UofC-GNCTR-2024/Claw-Machine-Mechanicals/pcb_enclosure/grommet - main (12mm).stl

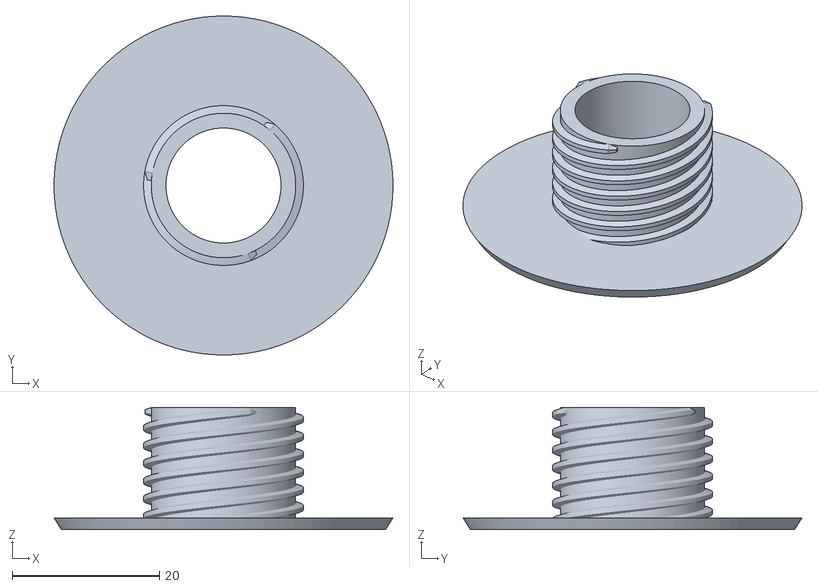
[picture p1: CAD file, 2023-12-17]
pcb_enclosure/grommet - main (12mm).stl
46.0 x 46.0 x 16.6
