UofC-GNCTR-2024/Claw-Machine-Mechanicals/pcb_enclosure/grommet - main (20mm).stl

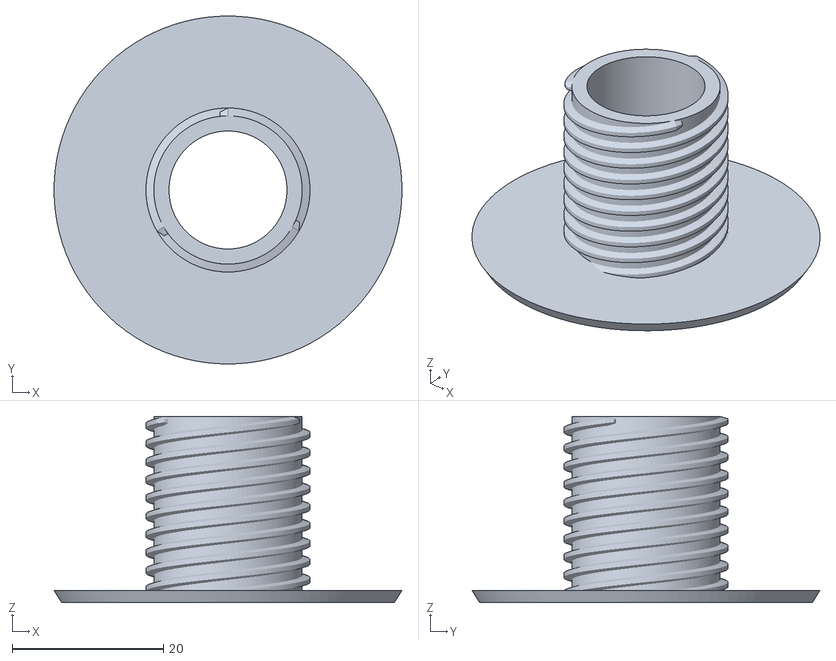
[picture p2: CAD file, 2023-12-17]
pcb_enclosure/grommet - main (20mm).stl
46.0 x 46.0 x 24.6
