UofC-GNCTR-2024/Claw-Machine-Mechanicals/axis_parts/sliders/y_axis_sled - bottom.stl

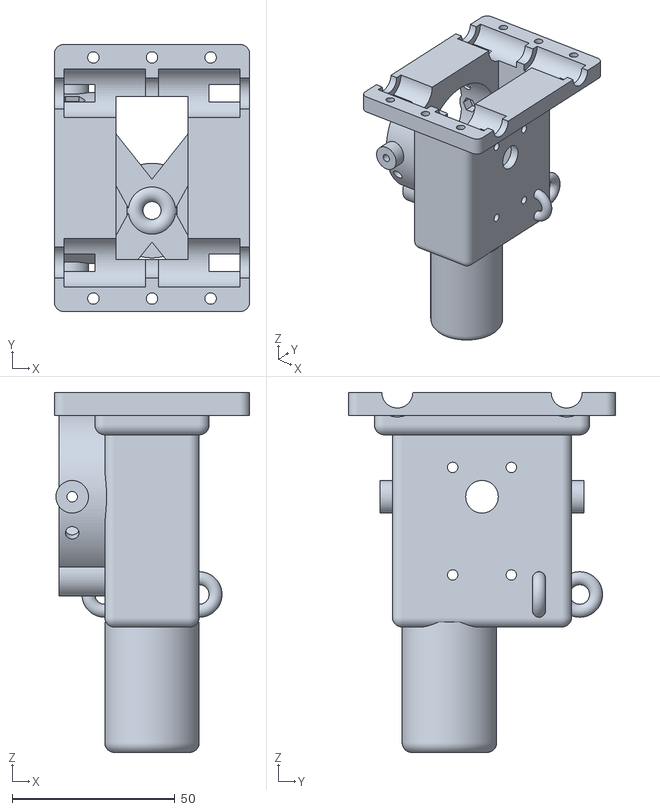
[picture p3: CAD file, 2024-01-09]
axis_parts/sliders/y_axis_sled - bottom.stl
60.0 x 82.0 x 110.5
