UofC-GNCTR-2024/Claw-Machine-Mechanicals/axis_parts/stationary_parts/x_idler_mount.stl

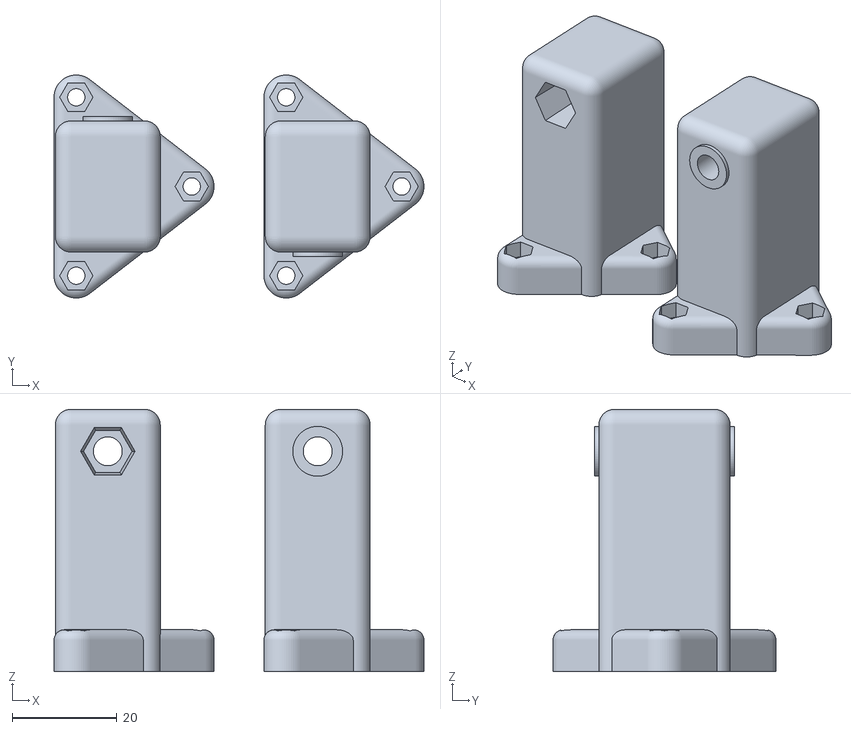
[picture p4: CAD file, 2023-11-20]
axis_parts/stationary_parts/x_idler_mount.stl
70.5 x 42.5 x 50.0
