UofC-GNCTR-2024/Claw-Machine-Mechanicals/claw_tip/claw_tip.stl

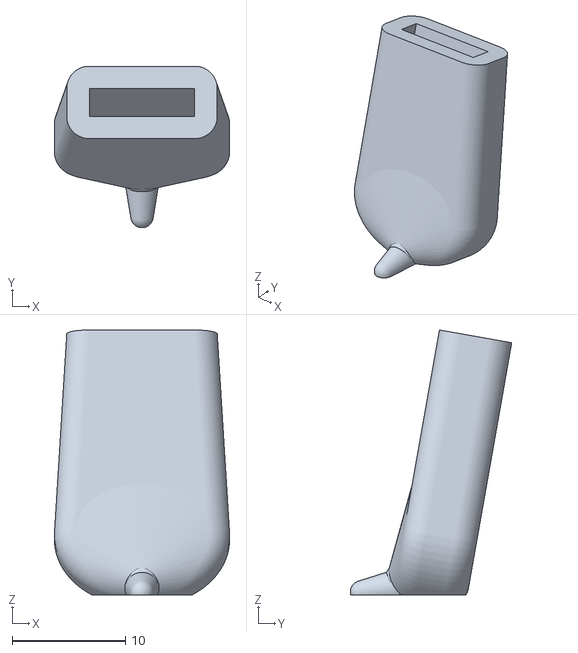
[picture p6: CAD file, 2024-01-07]
claw_tip/claw_tip.stl
15.5 x 14.3 x 23.4
