UofC-GNCTR-2024/Claw-Machine-Mechanicals/drag_chain_link.stl

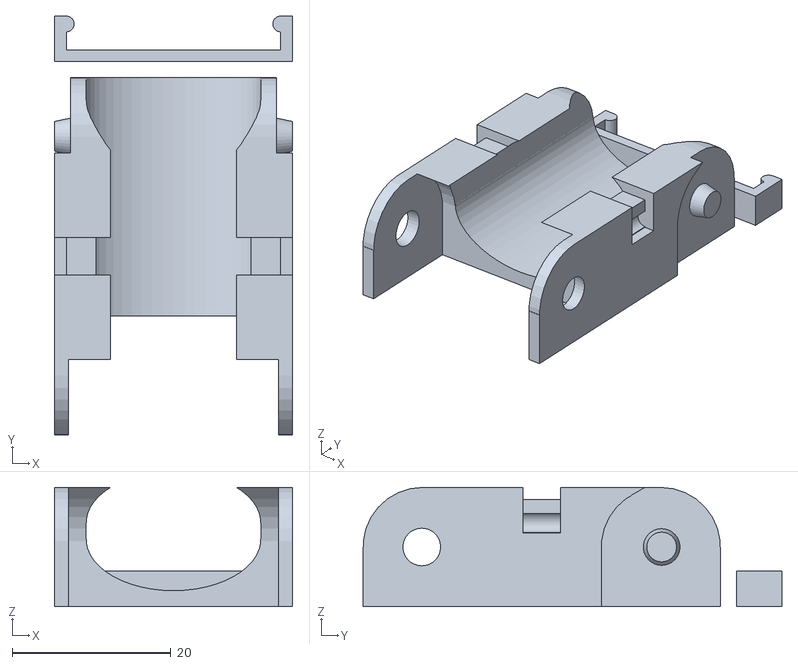
[picture p7: CAD file, 2023-11-08]
drag_chain_link.stl
30.0 x 52.8 x 15.0
