UofC-GNCTR-2024/Claw-Machine-Mechanicals/pulleys/parametricPulley_v3.stl

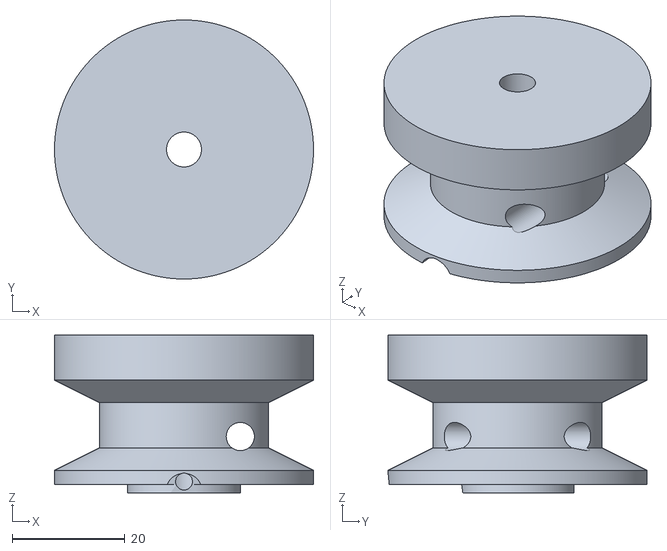
[picture p8: CAD file, 2023-11-24]
pulleys/parametricPulley_v3.stl
46.0 x 46.0 x 28.0
