UofC-GNCTR-2024/Claw-Machine-Mechanicals/toy_chute/toy_chute - top.stl

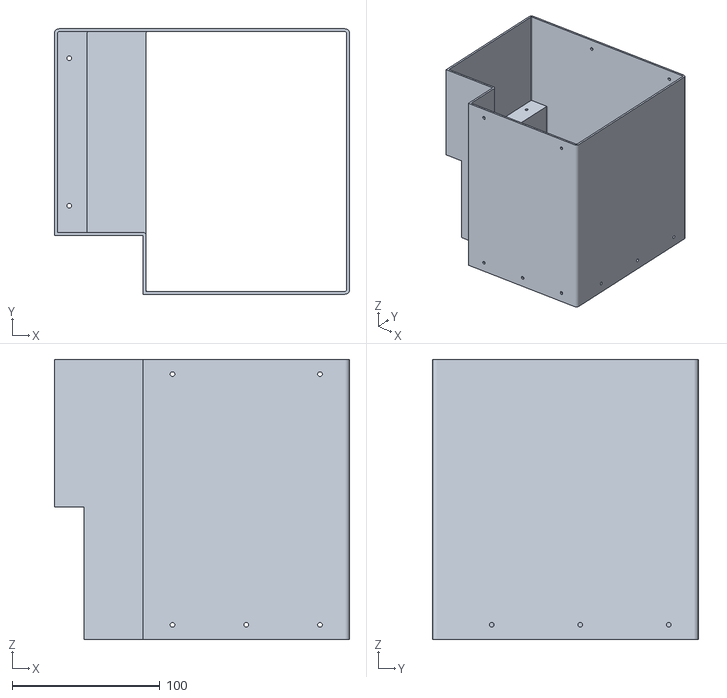
[picture p9: CAD file, 2023-12-26]
toy_chute/toy_chute - top.stl
200.0 x 180.0 x 190.0
