UofC-GNCTR-2024/Claw-Machine-Mechanicals/axis_parts/sliders/xy_slider - bumper (motor side).stl

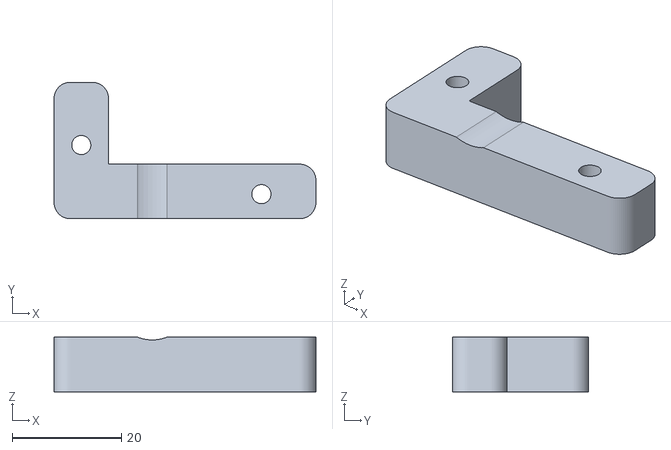
[picture p10: CAD file, 2024-01-07]
axis_parts/sliders/xy_slider - bumper (motor side).stl
48.0 x 25.0 x 10.0
