UofC-GNCTR-2024/Claw-Machine-Mechanicals/axis_parts/stationary_parts/x_motor_mount_raiser.stl

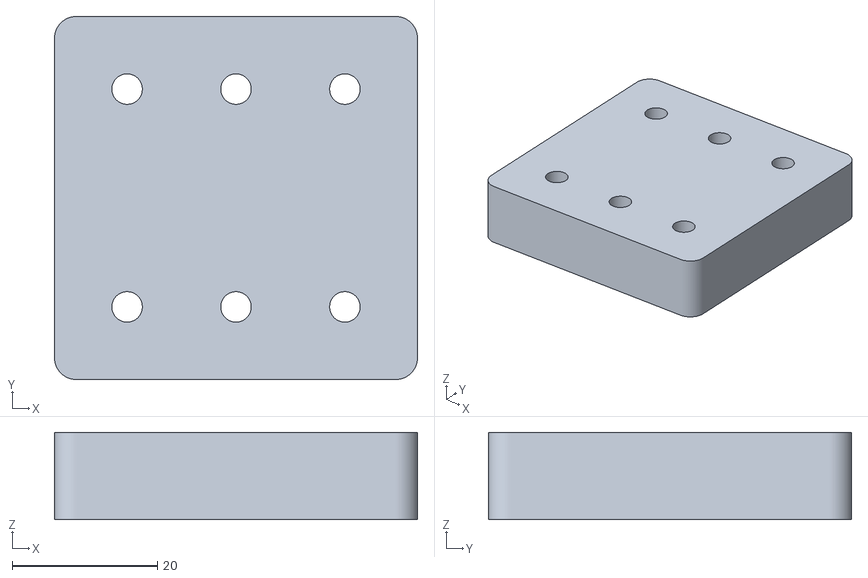
[picture p11: CAD file, 2023-11-19]
axis_parts/stationary_parts/x_motor_mount_raiser.stl
50.0 x 50.0 x 12.0
