UofC-GNCTR-2024/Claw-Machine-Mechanicals/belt_couplers/gt2_belt_coupler_y_axis.stl

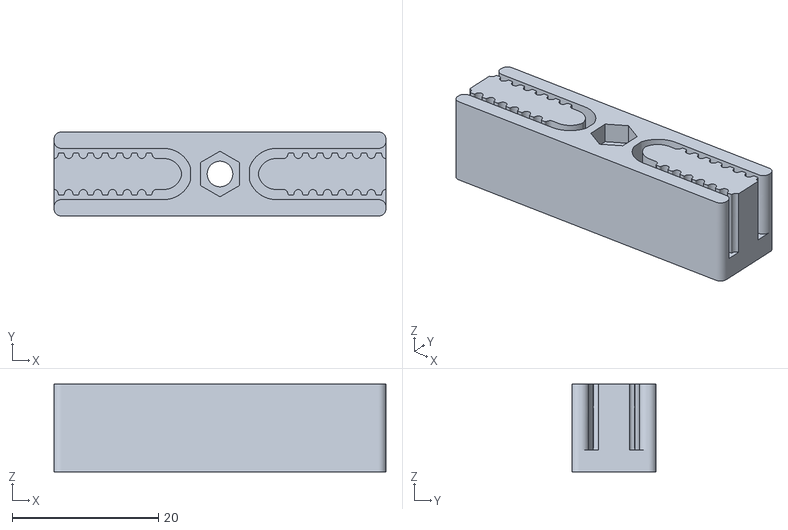
[picture p12: CAD file, 2023-11-26]
belt_couplers/gt2_belt_coupler_y_axis.stl
45.4 x 11.5 x 12.0
