UofC-GNCTR-2024/Claw-Machine-Mechanicals/player_panel/player_panel - bottom_plate.stl

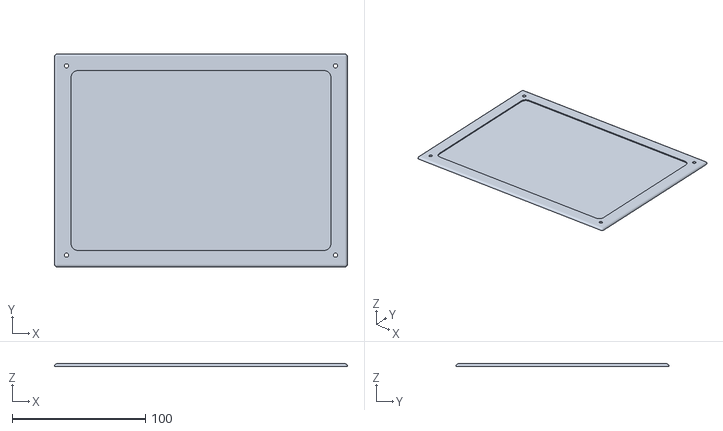
[picture p13: CAD file, 2023-12-27]
player_panel/player_panel - bottom_plate.stl
220.0 x 160.0 x 2.00
