UofC-GNCTR-2024/Claw-Machine-Mechanicals/pulleys/rope_pulley.stl

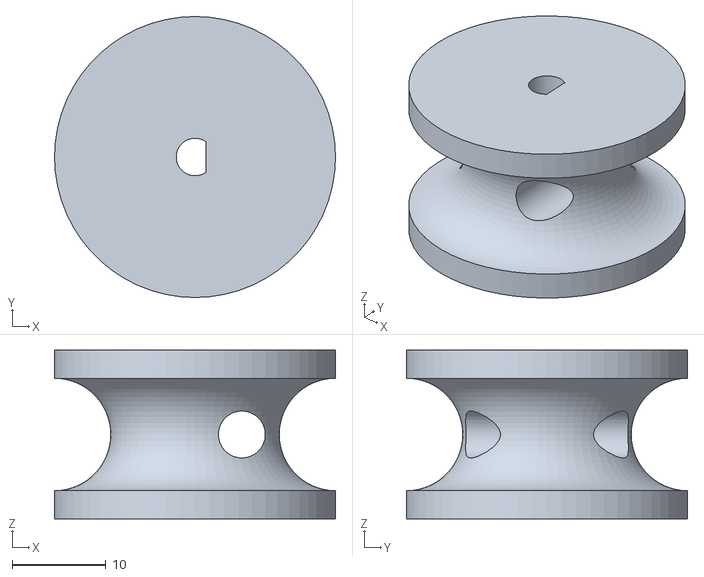
[picture p14: CAD file, 2023-11-09]
pulleys/rope_pulley.stl
30.0 x 30.0 x 18.0
