UofC-GNCTR-2024/Claw-Machine-Mechanicals/toy_chute/toy_chute - bottom.stl

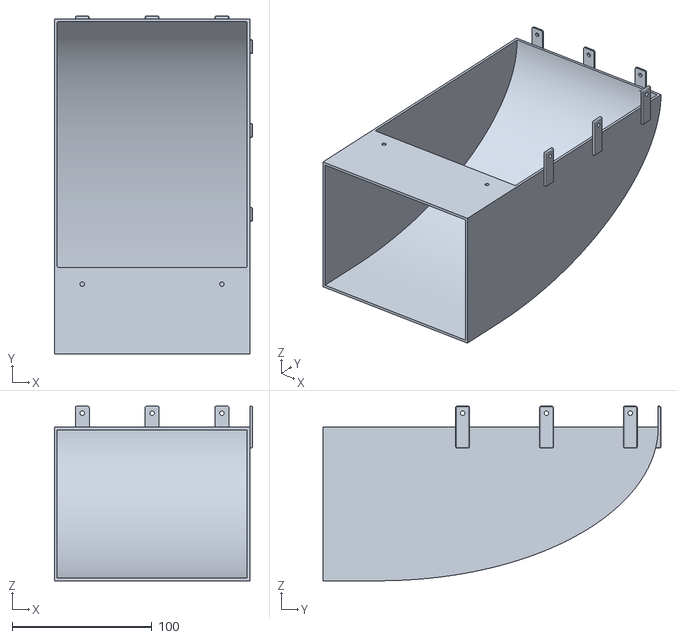
[picture p15: CAD file, 2023-12-19]
toy_chute/toy_chute - bottom.stl
142.0 x 242.0 x 125.0
