UofC-GNCTR-2024/Claw-Machine-Mechanicals/axis_parts/sliders/xy_slider - bumpers.stl

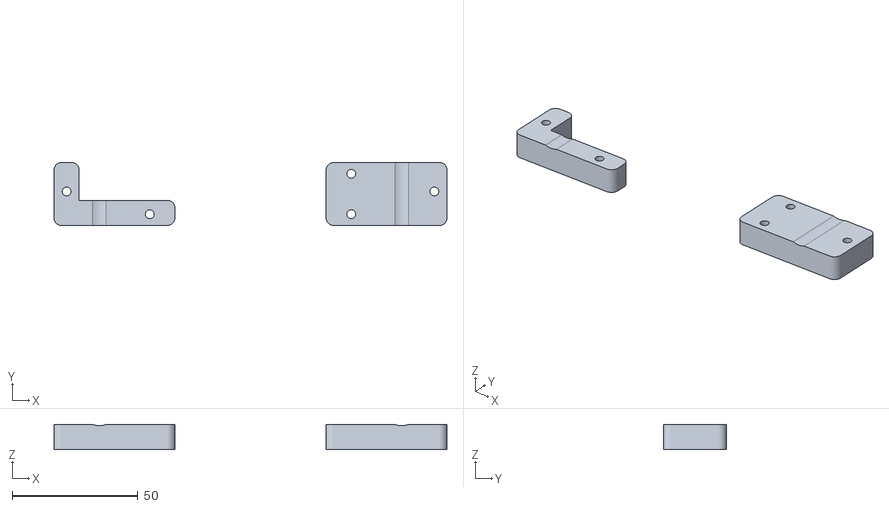
[picture p16: CAD file, 2024-01-07]
axis_parts/sliders/xy_slider - bumpers.stl
156.0 x 25.0 x 10.0
