UofC-GNCTR-2024/Claw-Machine-Mechanicals/axis_parts/stationary_parts/x_ends.stl

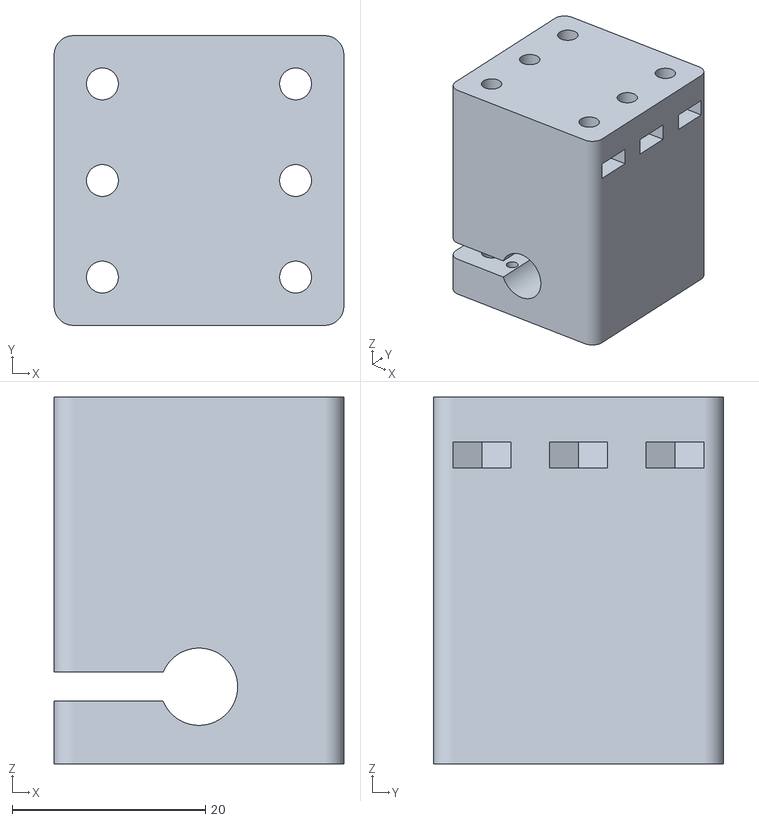
[picture p17: CAD file, 2023-11-09]
axis_parts/stationary_parts/x_ends.stl
30.0 x 30.0 x 38.0
