UofC-GNCTR-2024/Claw-Machine-Mechanicals/belt_couplers/gt2_belt_coupler.stl

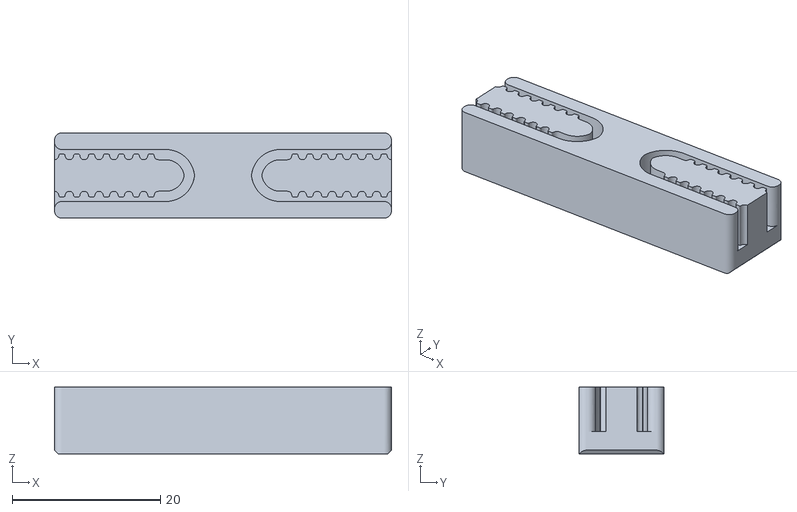
[picture p18: CAD file, 2023-11-26]
belt_couplers/gt2_belt_coupler.stl
45.4 x 11.5 x 9.00
