UofC-GNCTR-2024/Claw-Machine-Mechanicals/pcb_enclosure/claw_game_pcb_enclosure.stl

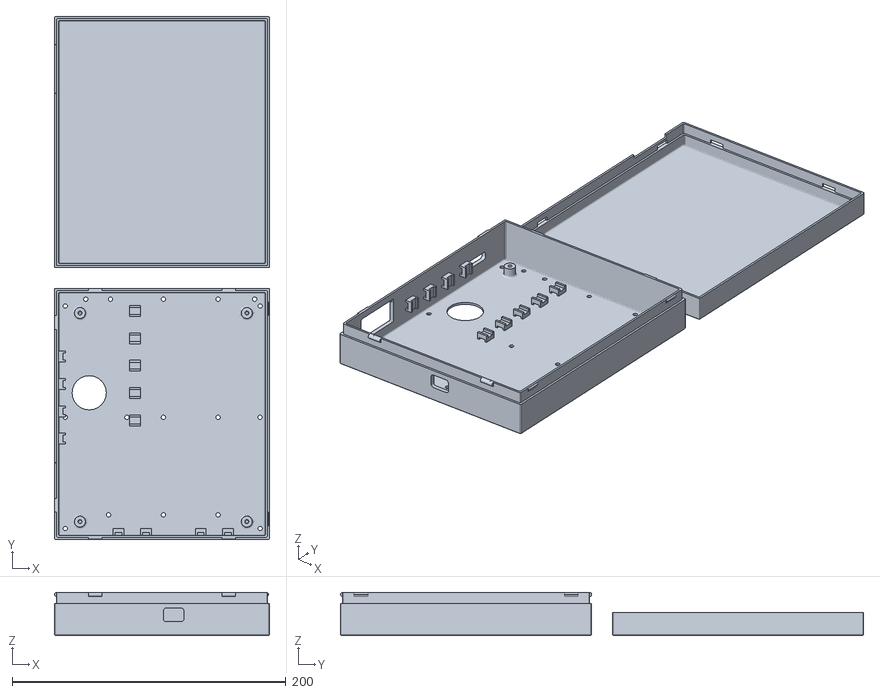
[picture p19: CAD file, 2023-12-17]
pcb_enclosure/claw_game_pcb_enclosure.stl
157.3 x 382.1 x 31.5
