UofC-GNCTR-2024/Claw-Machine-Mechanicals/player_panel/player_panel.stl

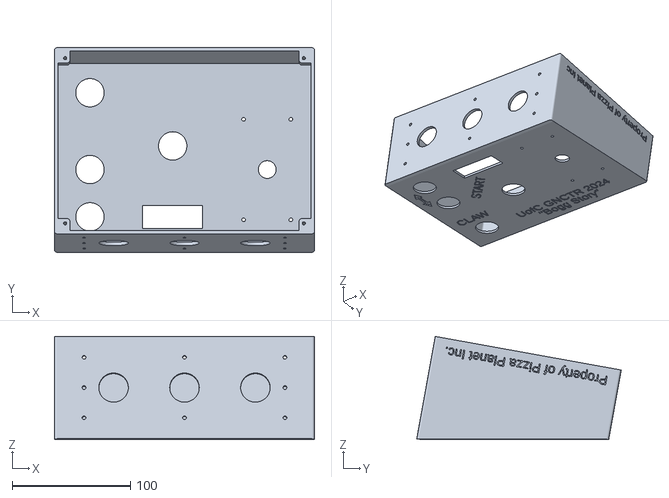
[picture p20: CAD file, 2023-12-18]
player_panel/player_panel.stl
220.0 x 173.1 x 87.3
