UofC-GNCTR-2024/Claw-Machine-Mechanicals/axis_parts/sliders/y_axis_sled - top.stl

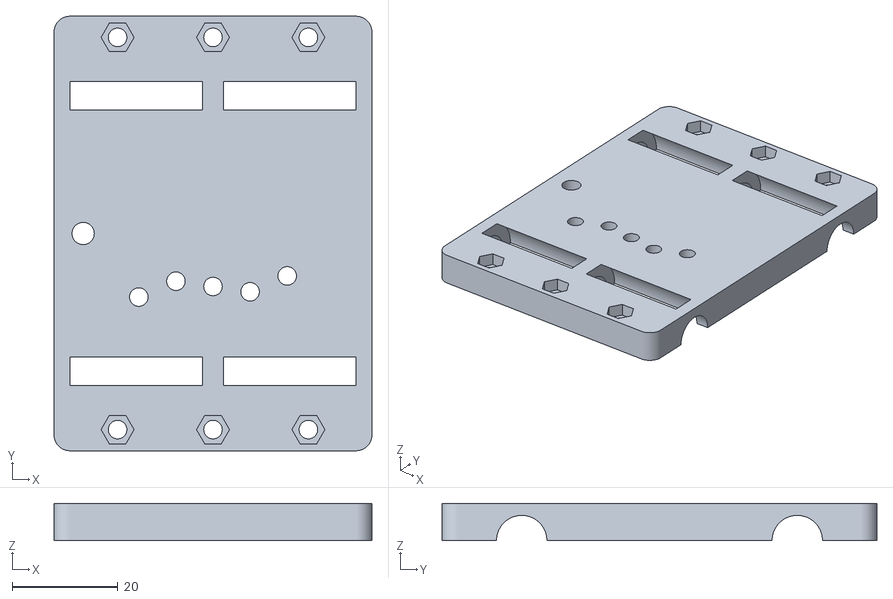
[picture p21: CAD file, 2024-01-07]
axis_parts/sliders/y_axis_sled - top.stl
60.0 x 82.0 x 7.00
