UofC-GNCTR-2024/Claw-Machine-Mechanicals/player_panel/player_panel - lcd_riser.stl

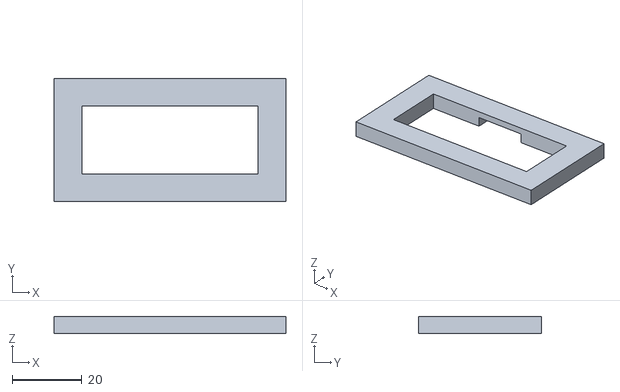
[picture p22: CAD file, 2023-12-18]
player_panel/player_panel - lcd_riser.stl
66.7 x 35.5 x 5.00
