UofC-GNCTR-2024/Claw-Machine-Mechanicals/axis_parts/sliders/xy_slider - top.stl

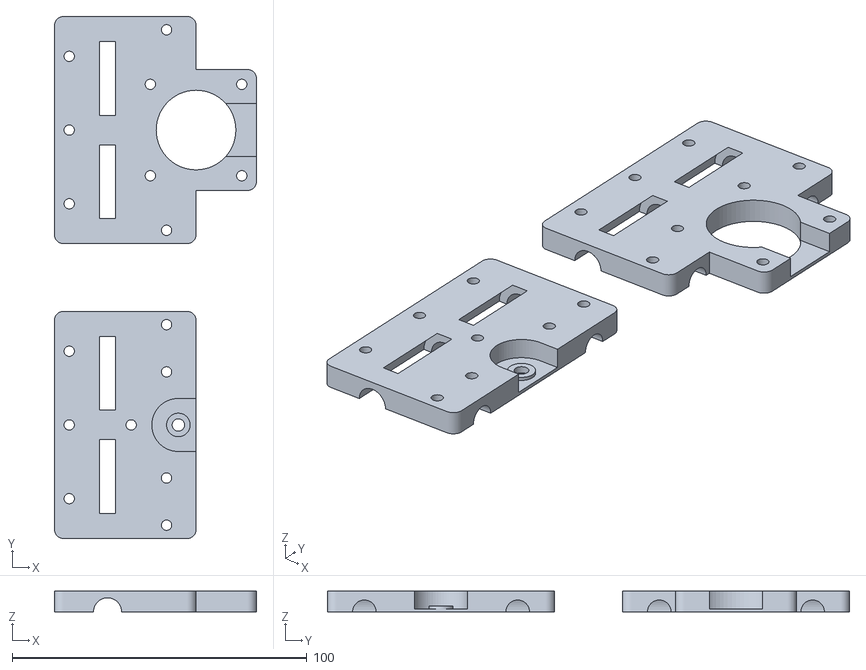
[picture p23: CAD file, 2023-11-08]
axis_parts/sliders/xy_slider - top.stl
68.5 x 177.0 x 7.00
