UofC-GNCTR-2024/Claw-Machine-Mechanicals/(list of files, cad)

Other CAD files:
axis_parts/sliders/xy_slider - bottom.stl
pcb_enclosure/grommet - nut.stl
player_panel/player_panel_washer.stl
