UofC-GNCTR-2024/Claw-Machine-Mechanicals/(commit log)

2023-11-07 Add initial pulley design
    [idler_pulley.scad]
2023-11-07 Modify base pulley design for first test
    [parametricPulley_v3.scad, parametricPulley_v3.stl]
2023-11-08 x_ends fixmes
    [x_ends.scad]
2023-11-08 Make xy_sliders
    [xy_slider - bottom.stl, xy_slider - top.stl, xy_slider.scad]
2023-11-08 Create y-axis sled (holds gearbox)
    [y_axis_sled - bottom.stl, y_axis_sled - top.stl, y_axis_sled.scad]
2023-11-08 Rename and render rope_pulley
    [rope_pulley.scad, rope_pulley.stl]
2023-11-08 Add motor mount info
    [x_ends.scad, xy_slider.scad]
2023-11-09 Resolve x_ends limit switch dimensions
    [x_ends.scad, x_ends.stl]
2023-11-09 Adjust pulley size, add rope hole
    [parametricPulley_v3.scad, parametricPulley_v3.stl]
2023-11-09 Update pulley dimensions, add rope hole
    [rope_pulley.scad, rope_pulley.stl]
2023-11-19 Create x_motor_mount_raiser and add gt2_belt_coupler from Thingiverse
    [gt2_belt_coupler.stl, x_motor_mount_raiser.scad, x_motor_mount_raiser.stl]
2023-11-20 Update y-axis sled with belt channel
    [y_axis_sled - top.stl, y_axis_sled.scad]
2023-11-20 Creat x_idler_mount
    [x_idler_mount.scad, x_idler_mount.stl]
2023-11-24 Change y_axis_sled to new worm gear gearbox
    [y_axis_sled.scad]
2023-11-24 Rotate gearbox, add limit switches to y_axis_sled
    [y_axis_sled - bottom.stl, y_axis_sled.scad]
2023-11-24 Update y_axis_sled wall_t and strength
    [y_axis_sled - bottom.stl, y_axis_sled.scad]
2023-11-24 Update pulley, switch to full pulley mounting cutout hole
    [parametricPulley_v3.scad, parametricPulley_v3.stl, y_axis_sled - bottom.stl, y_axis_sled.scad]
2023-11-26 Fix y-sled motor offset bug
    [y_axis_sled.scad]
2023-11-26 Fix y-axis sled belt interface
    [y_axis_sled - bottom.stl, y_axis_sled - top.stl, y_axis_sled.scad]
2023-11-26 Center the gt2_belt_coupler on the origin
    [gt2_belt_coupler.stl]
2023-11-26 Add modified belt couplers
    [gt2_belt_coupler_x_axis.scad, gt2_belt_coupler_x_axis.stl, gt2_belt_coupler_y_axis.scad, gt2_belt_coupler_y_axis.stl]
2023-12-10 Update core enclosure variables
    [claw_game_pcb_enclosure.scad]
2023-12-10 Clean enclosure up, add TODOs
    [claw_game_pcb_enclosure.scad]
2023-12-10 Add exported PCB rendering/model
2023-12-10 Finish v1 of the PCB enclosure
    [claw_game_pcb_enclosure - base.stl, claw_game_pcb_enclosure - lid.stl, claw_game_pcb_enclosure.scad]
2023-12-10 Fix lack of Power Supply cables, render
    [claw_game_pcb_enclosure - base.stl, claw_game_pcb_enclosure - lid.stl, claw_game_pcb_enclosure.scad, claw_game_pcb_enclosure.stl]
2023-12-11 Update corner rounding and wall thickness
    [claw_game_pcb_enclosure.scad, claw_game_pcb_enclosure.stl]
2023-12-14 Add grommet
    [grommet - main (12mm).stl, grommet - main (20mm).stl, grommet - nut.stl, grommet.scad]
2023-12-15 Attempt checkpoint
    [player_panel.scad]
2023-12-15 Create main shape and holes in back side
    [player_panel.scad]
2023-12-15 Add holes for buttons/stick on face
    [player_panel.scad]
2023-12-17 Update enclosure grommet
    [grommet - main (12mm).stl, grommet - main (20mm).stl, grommet - nut.stl, grommet.scad]
2023-12-18 Finish player panel
    [player_panel - lcd_riser.stl, player_panel.scad, player_panel.stl]
2023-12-18 Reorganize folders
    [gt2_belt_coupler.stl, gt2_belt_coupler_x_axis.scad, gt2_belt_coupler_x_axis.stl, gt2_belt_coupler_y_axis.scad, gt2_belt_coupler_y_axis.stl, parametricPulley_v3.scad, parametricPulley_v3.stl, player_panel.scad]
2023-12-19 Created toy chute rev1 - bottom printed
    [toy_chute - bottom.stl, toy_chute - top.stl, toy_chute.scad]
2023-12-26 Update chute
    [toy_chute - top.stl, toy_chute.scad]
2023-12-27 Create bottom plate for the player_panel
    [player_panel - bottom_plate.stl, player_panel.scad]
2024-01-06 Add player_panel_washerj
    [player_panel_washer.scad, player_panel_washer.stl]
2024-01-06 WIP improvements to y-sled
    [y_axis_sled.scad]
2024-01-07 Create v1 claw tips
    [claw_tip.scad, claw_tip.stl]
2024-01-07 WIP y-sled screw access and bolt to lock pulley in
    [y_axis_sled.scad]
2024-01-07 Finish y-sled upgrades with zprot_tube
    [y_axis_sled - bottom.stl, y_axis_sled.scad]
2024-01-07 Rerender `axis_parts\sliders\y_axis_sled - top.stl`
    [y_axis_sled - top.stl]
2024-01-07 Add xy_slider bumpers
    [xy_slider - bumpers.stl, xy_slider.scad]
2024-01-07 Fix motor-side xy sled bumper
    [xy_slider - bumper (motor side).stl, xy_slider - bumpers.stl, xy_slider.scad]
2024-01-09 Tiny update to zprot_tube_od - printed
    [y_axis_sled - bottom.stl, y_axis_sled.scad]
